eivinhj/cSLIM_nRF9160-DK_shield/readme.md

Shield design files of cSLIM shield hardware for nRF9160-DK.

Edit using KiCad: https://www.kicad.org/
