eivinhj/cSLIM_nRF9160-DK_shield/cSLIM-SHIELD/cSLIM-shield_bom2.xlsx

Id | Designator | Package | Quantity | Designation | Supplier and ref | OK?
1 | R801,R603,R701,R702,R703,R901,R902,R903,R906,R802,R803,R203,R804,R805,R1102,R1103 | R_0805_2012Metric | 16 | 100k | M
2 | P101 | Socket_Strip_Arduino_1x08 | 1 | Power | M
3 | P102 | Socket_Strip_Arduino_1x06 | 1 | Analog | M
4 | P104 | Socket_Strip_Arduino_1x10 | 1 | Digital | M
5 | P105,P106 | Socket_Strip_Arduino_1x08 | 2 | Digital | M
6 | H101,H102,H103,H106,H104,H105 | Arduino_1pin | 6 | CONN_01X01 | DNP
7 | P103 | PinHeader_2x03_P2.54mm_Vertical | 1 | Conn_02x03_Odd_Even | M
8 | C301,C401,C402,C403,C404,C405,C601,C604,C606,C901,C1001,C806,C810 | C_0603_1608Metric | 13 | 100nF | M
9 | C501 | C_0603_1608Metric | 1 | 12pF | M
10 | C602,C603,C902 | C_0603_1608Metric | 3 | 1uF | M
11 | C605 | C_0603_1608Metric | 1 | 10uF | M
12 | C607 | C_0603_1608Metric | 1 | 22uF | M
13 | FB501 | C_0603_1608Metric | 1 | 500mA | M
14 | IC201 | WLR089U0IRM | 1 | WLR089U0-I_RM | M
15 | IC301 | SOIC127P600X175-8N | 1 | MAX3486ESA+ | M
16 | IC302 | SOP65P490X110-8N | 1 | MAX3471EUA+ | DNP
17 | IC401 | SOP65P640X110-16N | 1 | MAX3221CUE+ | M
18 | IC601 | SOP65P640X120-8N | 1 | TPS2113PWR | M
19 | IC701,IC902,IC801 | SOP65P640X120-16N | 3 | SN74AVC4T774PWR | M
20 | IC702,IC903,IC802,IC202 | SOT95P230X110-3N | 4 | NX2301P,215 | M
21 | IC901 | NEO-M8T | 1 | NEO-M9N-00B | Best.tdl
22 | J101,J102 | PinSocket_1x03_P2.54mm_Vertical | 2 | Conn_01x03_Male
23 | J501,J505,J511 | PinSocket_1x02_P2.54mm_Vertical | 3 | Conn_01x02_Male | M
24 | J502 | PinSocket_1x04_P2.54mm_Vertical | 1 | Conn_01x04 | M
25 | J503 | PinSocket_1x06_P2.54mm_Vertical | 1 | Conn_01x06 | M
26 | J506 | 1040310811 | 1 | 104031-0811 | M
27 | J507 | CONUFL001-SMD | 1 | CONUFL001-SMD-T | https://www.digikey.no/product-detail/en/linx-technologies-inc/CONUFL001-SMD-T/CONUFL001-SMD-TCT-ND/7427733
28 | J508 | SHF-105-01-X-D-SM | 1 | SHF-105-01-L-D-SM | 1
29 | J509,J510 | BM05BZESSTBTLFSN | 2 | BM05B-ZESS-TBT__LF__SN_ | https://no.farnell.com/jst-japan-solderless-terminals/bm05b-zess-tbt/header-ze-top-smt-1-5mm-5way/dp/2320430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
30 | L601 | LPS3015 | 1 | LPS3015-222MRB | M
31 | L901 | L_0805_2012Metric | 1 | L | DNP
32 | LED501 | LEDC2012X75N | 1 | APT2012LSECK_J3-PRV | M
33 | LED502 | LEDC2012X85N | 1 | APT2012LSYCK_J3-PRV | M
34 | LED503 | LEDC2012X85N | 1 | APT2012LZGCK | M
35 | LED504,LED505 | LEDC2012X85N | 2 | APT2012LVBC_D | M
36 | Q901 | SOTFL50P160X60-6N | 1 | SI1040X-T1-GE3 | DNP
37 | R301 | R_0805_2012Metric | 1 | 120R | M
38 | R501,R502 | R_0805_2012Metric | 2 | 15R | M
39 | R503,R508,R509,R904,R511 | R_0805_2012Metric | 5 | 0R | M
40 | R504,R505 | R_0805_2012Metric | 2 | 820R | M
41 | R506,R507,R510 | R_0805_2012Metric | 3 | 330R | M
42 | R601,R609 | R_0805_2012Metric | 2 | 240k | M
43 | R602,R606 | R_0805_2012Metric | 2 | 1M | M
44 | R604 | R_0805_2012Metric | 1 | 390R | M
45 | R605 | R_0805_2012Metric | 1 | 1k | M
46 | R607 | R_0805_2012Metric | 1 | 100R | M
47 | R608 | R_0805_2012Metric | 1 | 1M2 | M
48 | R905 | R_0805_2012Metric | 1 | 10R | M
49 | R1001,R1002 | R_0805_2012Metric | 2 | 33R | M
50 | R1003 | R_0805_2012Metric | 1 | 50R | M
51 | S201 | SOIC127P671X170-16N | 1 | 97C08ST | M
52 | S601,PB1,PB2 | TLSA070JLFS | 3 | TLS_A_070J_LFS | M
53 | U501 | SOT-23-6 | 1 | USBLC6-2SC6 | M
54 | U601 | Texas_DRC0010J_ThermalVias | 1 | TPS63000 | M
55 | C608 | C_0603_1608Metric | 1 | 1.8pF | M
56 | C807 | C_0603_1608Metric | 1 | 1uF/50V | M
57 | FB801,FB802 | C_0603_1608Metric | 2 | Ferrite_Bead | M
58 | J504 | 10119313302TLF | 1 | 10119313-302TLF | M
59 | J802 | 52746-1071 | 1 | 52746-1071 | M
60 | R101,R102 | R_0805_2012Metric | 2 | 4.7k | M
61 | R1101 | R_0805_2012Metric | 1 | 10k | M
62 | Y1101 | RV3032C7TAQA | 1 | RV-3032-C7-TA-QC
63 | IC1001 | SON65P323X328X55-8N | 1 | CY15B108QN-20LPXC | M
Extra
 |  | Wires for RS485 RS232 | 25 |  | https://no.rs-online.com/web/p/pre-crimped-leads/8201396/
 |  | Housing for connectors | 10 |  | https://no.rs-online.com/web/p/wire-housings-plugs/8201365/?matchtype=&pla-339234368854&gclsrc=aw.ds
 |  | GPS-antenna
 |  | LoRa-antenna
 |  | RS485-Wet cable connector
 |  | u.fl to screw terminal
 |  | vanntett boks
 |  | Batteri
 |  | Antennekabel
