eivinhj/cSLIM_nRF9160-DK_shield/(list of files, drawings)

Other design files:
cSLIM-SHIELD/cSLIM-shield_test_routing.dsn
cSLIM-SHIELD/cSLIM-shield_test_routing_net_classes.dsn
cSLIM-SHIELD/cSLIM-shield_test_routing_net_classes_2.dsn
cSLIM-SHIELD/cSLIM-shield_test_routing_net_classes_3.dsn
cSLIM-SHIELD/cSLIM-shield_test_routing_net_classes_4.dsn
cSLIM-SHIELD/cSLIM-shield_test_routing_net_classes_5.dsn
cSLIM-SHIELD/cSLIM-shield_test_routing_net_classes_6.dsn
cSLIM-SHIELD/cSLIM-shield_test_routing_net_classes_7.dsn
cSLIM-SHIELD/cSLIM-shield_test_routing_net_classes_10.dsn
