eivinhj/cSLIM_nRF9160-DK_shield/cSLIM-SHIELD/cSLIM-shield.kicad_pcb

## KiCad design cSLIM-SHIELD/cSLIM-shield.kicad_pcb (2021-08-10)

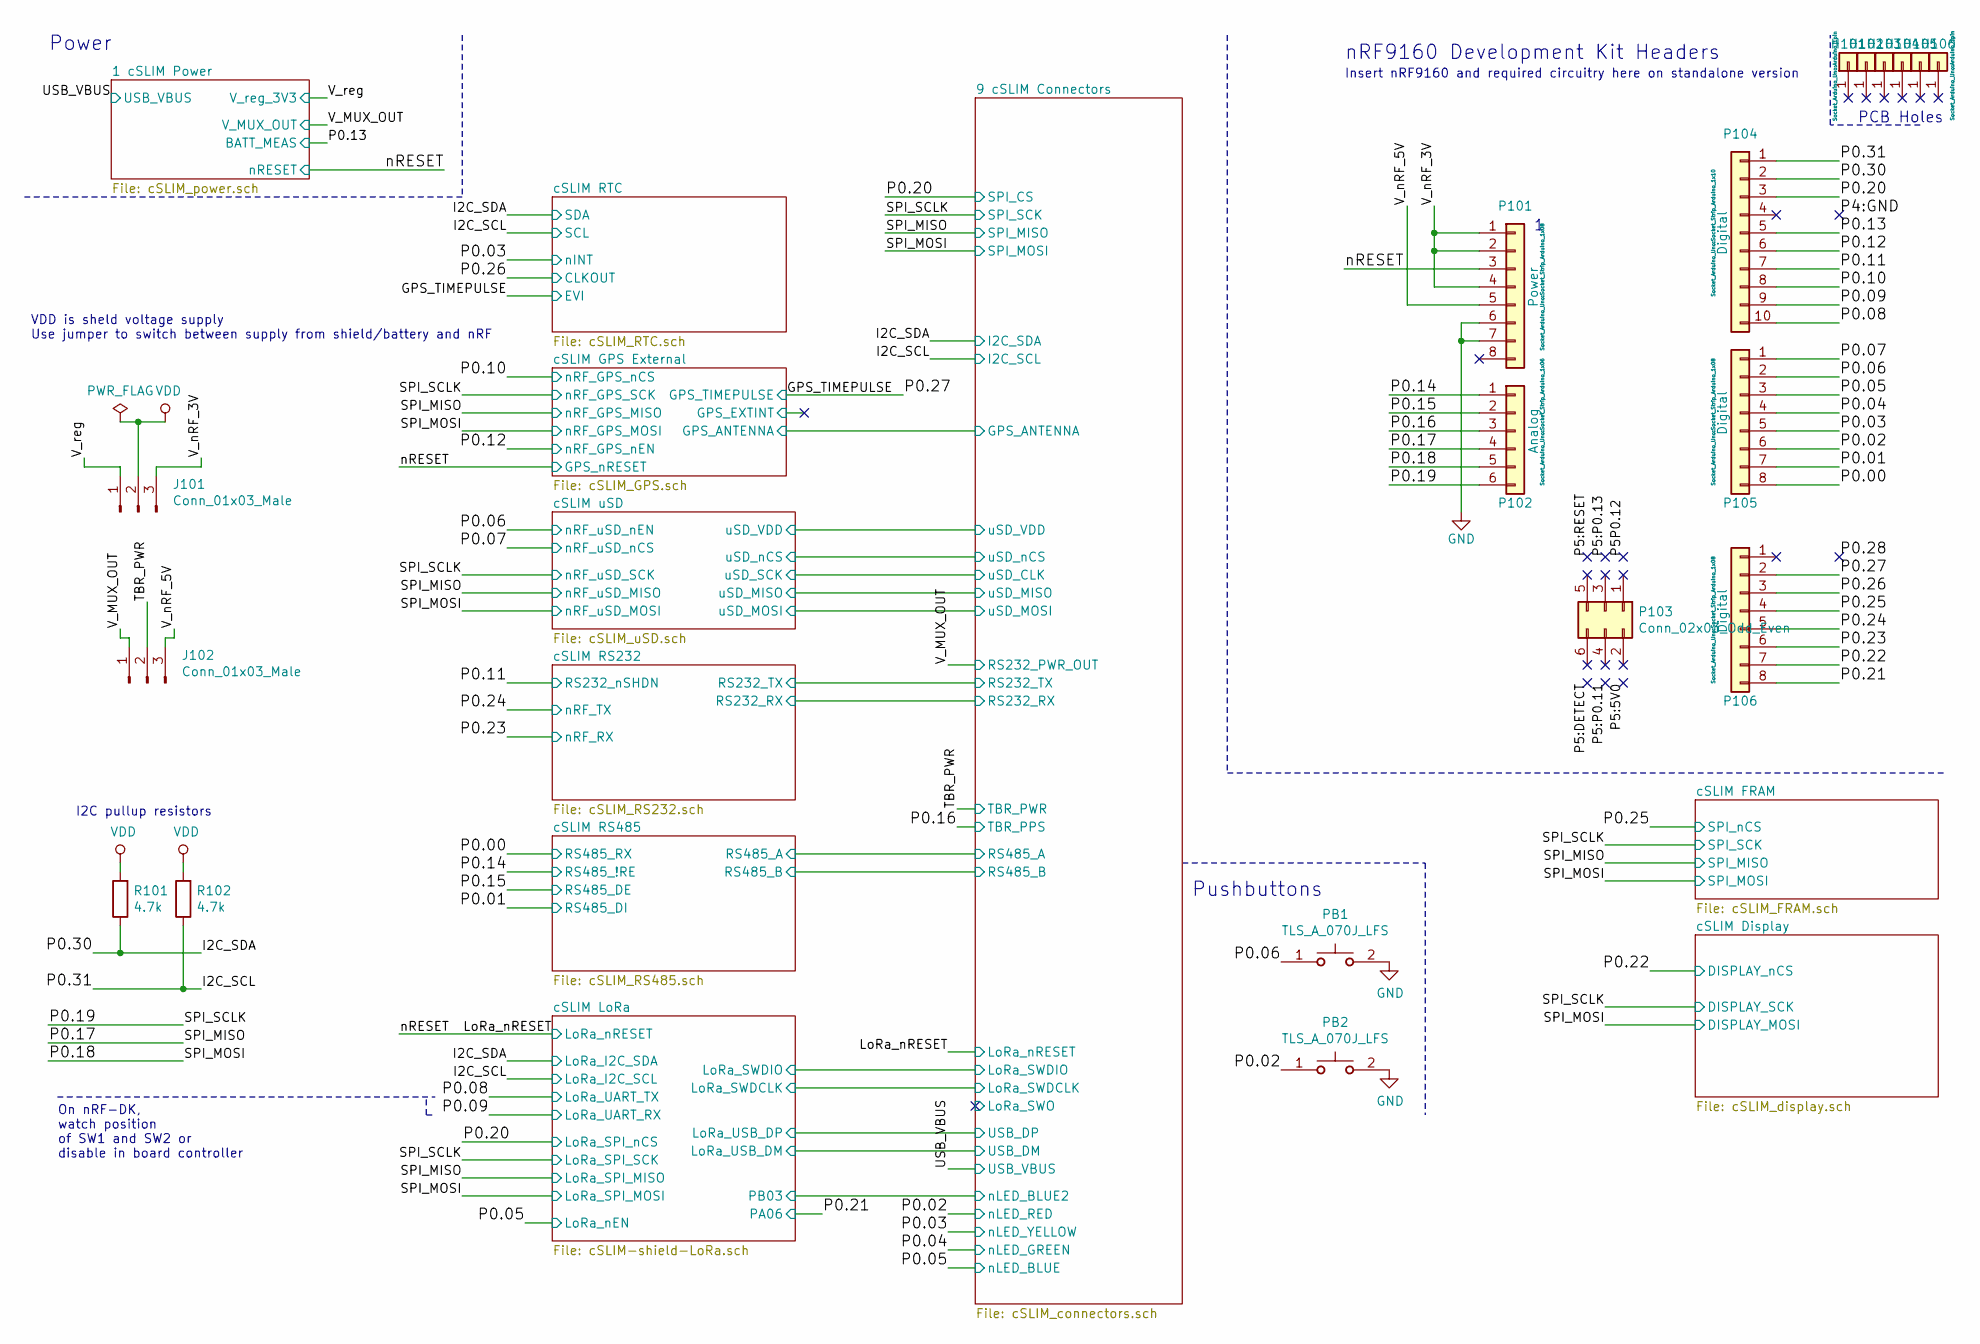
[picture p1: schematic cSLIM-shield.sch, cSLIM Overview]

Parts:
H101, H102, H103, H104, H105, H106: CONN_01X01; Arduino_1pin
J101, J102: Conn_01x03_Male; PinSocket_1x03_P2.54mm_Vertical
P101: Power; Socket_Strip_Arduino_1x08
P102: Analog; Socket_Strip_Arduino_1x06
P103: Conn_02x03_Odd_Even; PinHeader_2x03_P2.54mm_Vertical
P104: Digital; Socket_Strip_Arduino_1x10
P105, P106: Digital; Socket_Strip_Arduino_1x08
PB1, PB2: TLS_A_070J_LFS; TLSA070JLFS; Mouser Part Number 611-TLSA070JLFS
R101, R102: 4.7k; R_0805_2012Metric

Connections:
/GPS_TIMEPULSE: P106.2; also elsewhere on the board
/I2C_SCL: P104.1, R102.1; also elsewhere on the board
/I2C_SDA: P104.2, R101.1; also elsewhere on the board
/LoRa_nRESET: P101.3; also elsewhere on the board
/P0.00: P105.8; also elsewhere on the board
/P0.01: P105.7; also elsewhere on the board
/P0.02: P105.6, PB2.1; also elsewhere on the board
/P0.03: P105.5; also elsewhere on the board
/P0.04: P105.4; also elsewhere on the board
/P0.05: P105.3; also elsewhere on the board
/P0.06: P105.2, PB1.1; also elsewhere on the board
/P0.07: P105.1; also elsewhere on the board
/P0.08: P104.10; also elsewhere on the board
/P0.09: P104.9; also elsewhere on the board
/P0.10: P104.8; also elsewhere on the board
/P0.11: P104.7; also elsewhere on the board
/P0.12: P104.6; also elsewhere on the board
/P0.13: P104.5; also elsewhere on the board
/P0.14: P102.1; also elsewhere on the board
/P0.15: P102.2; also elsewhere on the board
/P0.16: P102.3; also elsewhere on the board
/P0.17: P102.4; also elsewhere on the board
/P0.18: P102.5; also elsewhere on the board
/P0.19: P102.6; also elsewhere on the board
/P0.20: P104.3; also elsewhere on the board
/P0.21: P106.8; also elsewhere on the board
/P0.22: P106.7; also elsewhere on the board
/P0.23: P106.6; also elsewhere on the board
/P0.24: P106.5; also elsewhere on the board
/P0.25: P106.4; also elsewhere on the board
/P0.26: P106.3; also elsewhere on the board
/TBR_PWR: J102.2; also elsewhere on the board
/V_MUX_OUT: J102.1; also elsewhere on the board
/V_nRF_3V: J101.3, P101.1, P101.2, P101.4
/V_nRF_5V: J102.3, P101.5
/V_reg: J101.1; also elsewhere on the board
GND: P101.6, P101.7, PB1.2, PB2.2; also elsewhere on the board
VDD: J101.2, R101.2, R102.2; also elsewhere on the board

Notes on the sheet:
PCB Holes
VDD is sheld voltage supply Use jumper to switch between supply from shield/battery and nRF
On nRF-DK, watch position of SW1 and SW2 or disable in board controller
nRF9160 Development Kit Headers
I2C pullup resistors
Pushbuttons
Insert nRF9160 and required circuitry here on standalone version
Power

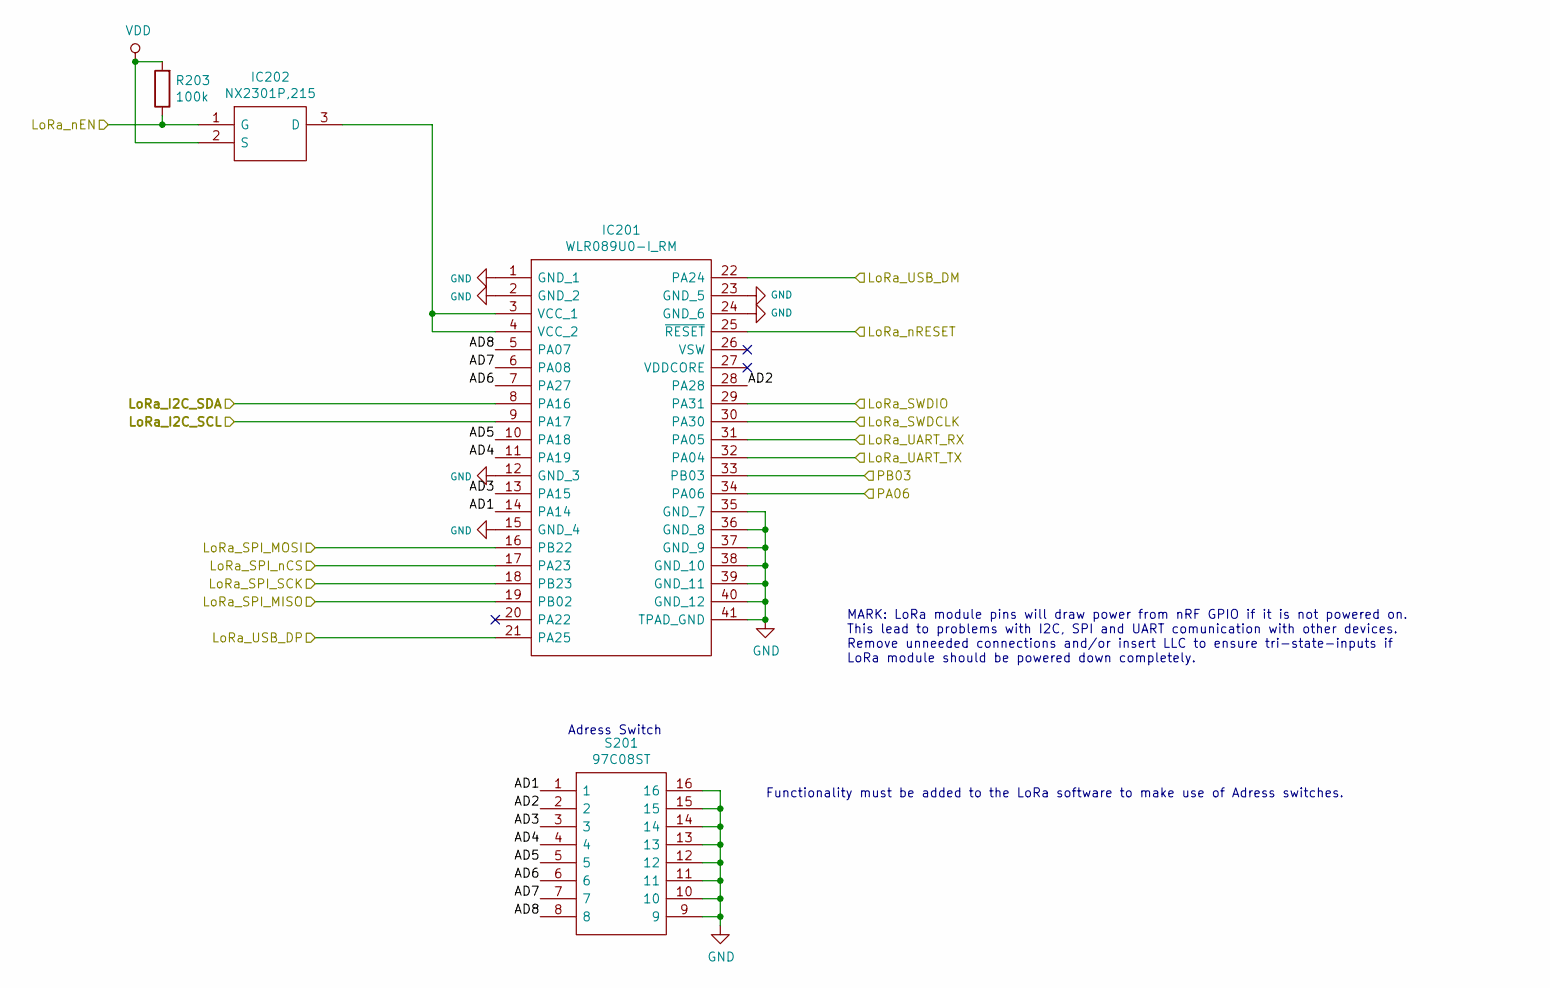
[picture p2: schematic cSLIM-shield-LoRa.sch, cSLIM LoRa Module]

Parts:
IC201: WLR089U0-I_RM; WLR089U0IRM; Mouser Part Number 579-WLR089U0-I/RM
IC202: NX2301P,215; SOT95P230X110-3N; Mouser Part Number 771-NX2301P215
R203: 100k; R_0805_2012Metric
S201: 97C08ST; SOIC127P671X170-16N; Mouser Part Number 706-97C08ST

Connections:
/9 cSLIM Connectors/LoRa_SWDCLK: IC201.30 (PA30); also elsewhere on the board
/9 cSLIM Connectors/LoRa_SWDIO: IC201.29 (PA31); also elsewhere on the board
/I2C_SCL: IC201.9 (PA17); also elsewhere on the board
/I2C_SDA: IC201.8 (PA16); also elsewhere on the board
/LoRa_nRESET: IC201.25 (~RESET); also elsewhere on the board
/P0.05: IC202.1 (G), R203.1; also elsewhere on the board
/P0.08: IC201.32 (PA04); also elsewhere on the board
/P0.09: IC201.31 (PA05); also elsewhere on the board
/P0.17: IC201.19 (PB02); also elsewhere on the board
/P0.18: IC201.16 (PB22); also elsewhere on the board
/P0.19: IC201.18 (PB23); also elsewhere on the board
/P0.20: IC201.17 (PA23); also elsewhere on the board
/P0.21: IC201.34 (PA06); also elsewhere on the board
/cSLIM LoRa/AD1: IC201.14 (PA14), S201.1
/cSLIM LoRa/AD2: IC201.28 (PA28), S201.2
/cSLIM LoRa/AD3: IC201.13 (PA15), S201.3
/cSLIM LoRa/AD4: IC201.11 (PA19), S201.4
/cSLIM LoRa/AD5: IC201.10 (PA18), S201.5
/cSLIM LoRa/AD6: IC201.7 (PA27), S201.6
/cSLIM LoRa/AD7: IC201.6 (PA08), S201.7
/cSLIM LoRa/AD8: IC201.5 (PA07), S201.8
/cSLIM LoRa/LoRa_USB_DM: IC201.22 (PA24); also elsewhere on the board
/cSLIM LoRa/LoRa_USB_DP: IC201.21 (PA25); also elsewhere on the board
/cSLIM LoRa/PB03: IC201.33 (PB03); also elsewhere on the board
GND: IC201.1 (GND_1), IC201.2 (GND_2), IC201.12 (GND_3), IC201.15 (GND_4), IC201.23 (GND_5), IC201.24 (GND_6), IC201.35 (GND_7), IC201.36 (GND_8), IC201.37 (GND_9), IC201.38 (GND_10), IC201.39 (GND_11), IC201.40 (GND_12), IC201.41 (TPAD_GND), S201.9, S201.10, S201.11, S201.12, S201.13, S201.14, S201.15, S201.16; also elsewhere on the board
unnamed: IC201.3 (VCC_1), IC201.4 (VCC_2), IC202.3 (D)
VDD: IC202.2 (S), R203.2; also elsewhere on the board

Notes on the sheet:
Adress Switch
MARK: LoRa module pins will draw power from nRF GPIO if it is not powered on. This lead to problems with I2C, SPI and UART comunication with other devices. Remove unneeded connections and/or insert LLC to ensure tri-state-inputs if LoRa module should be powered down completely.
Functionality must be added to the LoRa software to make use of Adress switches.

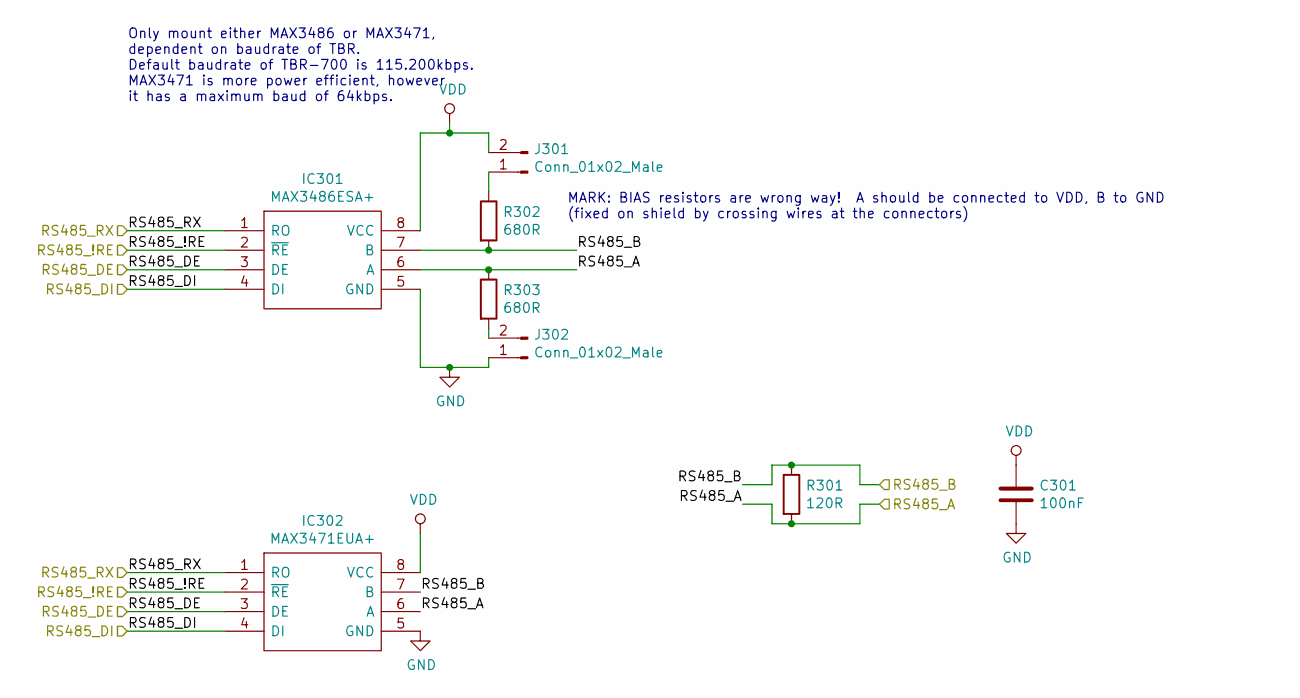
[picture p3: schematic cSLIM_RS485.sch, cSLIM RS485]

Parts:
C301: 100nF; C_0603_1608Metric
IC301: MAX3486ESA+; SOIC127P600X175-8N; Mouser Part Number 700-MAX3486ESA
IC302: MAX3471EUA+; SOP65P490X110-8N; Mouser Part Number 700-MAX3471EUA
J301, J302: Conn_01x02_Male; PinSocket_1x02_P2.54mm_Vertical
R301: 120R; R_0805_2012Metric
R302, R303: 680R; R_0805_2012Metric

Connections:
/9 cSLIM Connectors/RS485_A: IC301.6 (A), IC302.6 (A), R301.2, R303.1; also elsewhere on the board
/9 cSLIM Connectors/RS485_B: IC301.7 (B), IC302.7 (B), R301.1, R302.2; also elsewhere on the board
/P0.00: IC301.1 (RO), IC302.1 (RO); also elsewhere on the board
/P0.01: IC301.4 (DI), IC302.4 (DI); also elsewhere on the board
/P0.14: IC301.2 (~RE), IC302.2 (~RE); also elsewhere on the board
/P0.15: IC301.3 (DE), IC302.3 (DE); also elsewhere on the board
GND: C301.2, IC301.5 (GND), IC302.5 (GND), J302.1; also elsewhere on the board
unnamed: J301.1, R302.1
unnamed: J302.2, R303.2
VDD: C301.1, IC301.8 (VCC), IC302.8 (VCC), J301.2; also elsewhere on the board

Notes on the sheet:
Only mount either MAX3486 or MAX3471, dependent on baudrate of TBR. Default baudrate of TBR-700 is 115.200kbps. MAX3471 is more power efficient, however it has a maximum baud of 64kbps.
MARK: BIAS resistors are wrong way! A should be connected to VDD, B to GND (fixed on shield by crossing wires at the connectors)

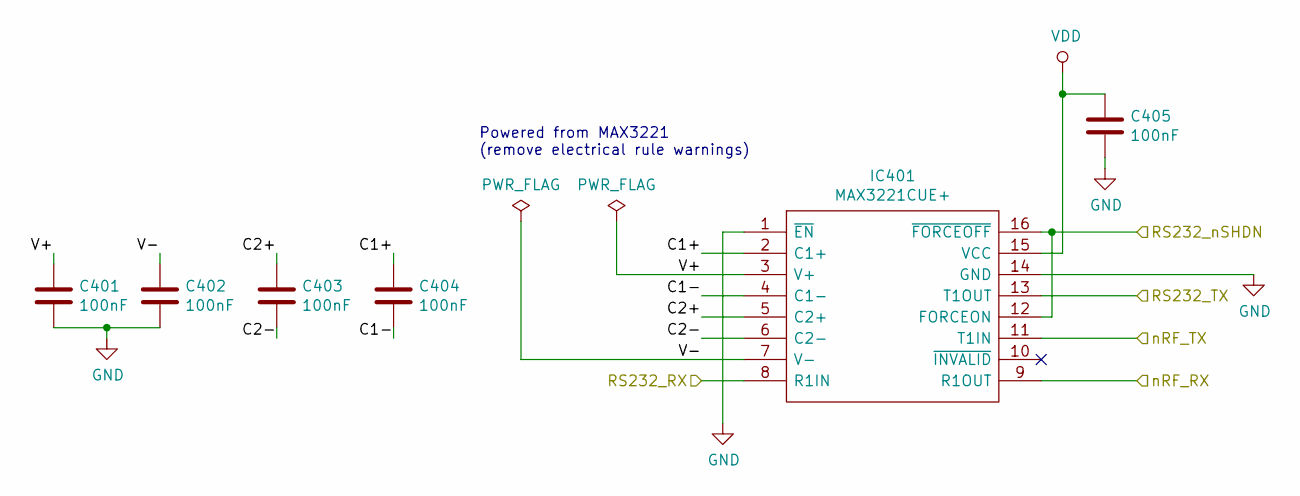
[picture p4: schematic cSLIM_RS232.sch, cSLIM RS232]

Parts:
C401, C402, C403, C404, C405: 100nF; C_0603_1608Metric
IC401: MAX3221CUE+; SOP65P640X110-16N; Mouser Part Number 700-MAX3221CUE

Connections:
/9 cSLIM Connectors/RS232_RX: IC401.8 (R1IN); also elsewhere on the board
/9 cSLIM Connectors/RS232_TX: IC401.13 (T1OUT); also elsewhere on the board
/P0.11: IC401.12 (FORCEON), IC401.16 (~FORCEOFF); also elsewhere on the board
/P0.23: IC401.9 (R1OUT); also elsewhere on the board
/P0.24: IC401.11 (T1IN); also elsewhere on the board
/cSLIM RS232/C1+: C404.1, IC401.2 (C1+)
/cSLIM RS232/C1-: C404.2, IC401.4 (C1-)
/cSLIM RS232/C2+: C403.1, IC401.5 (C2+)
/cSLIM RS232/C2-: C403.2, IC401.6 (C2-)
/cSLIM RS232/V+: C401.1, IC401.3 (V+)
/cSLIM RS232/V-: C402.1, IC401.7 (V-)
GND: C401.2, C402.2, C405.2, IC401.1 (~EN), IC401.14 (GND); also elsewhere on the board
VDD: C405.1, IC401.15 (VCC); also elsewhere on the board

Notes on the sheet:
Powered from MAX3221 (remove electrical rule warnings)

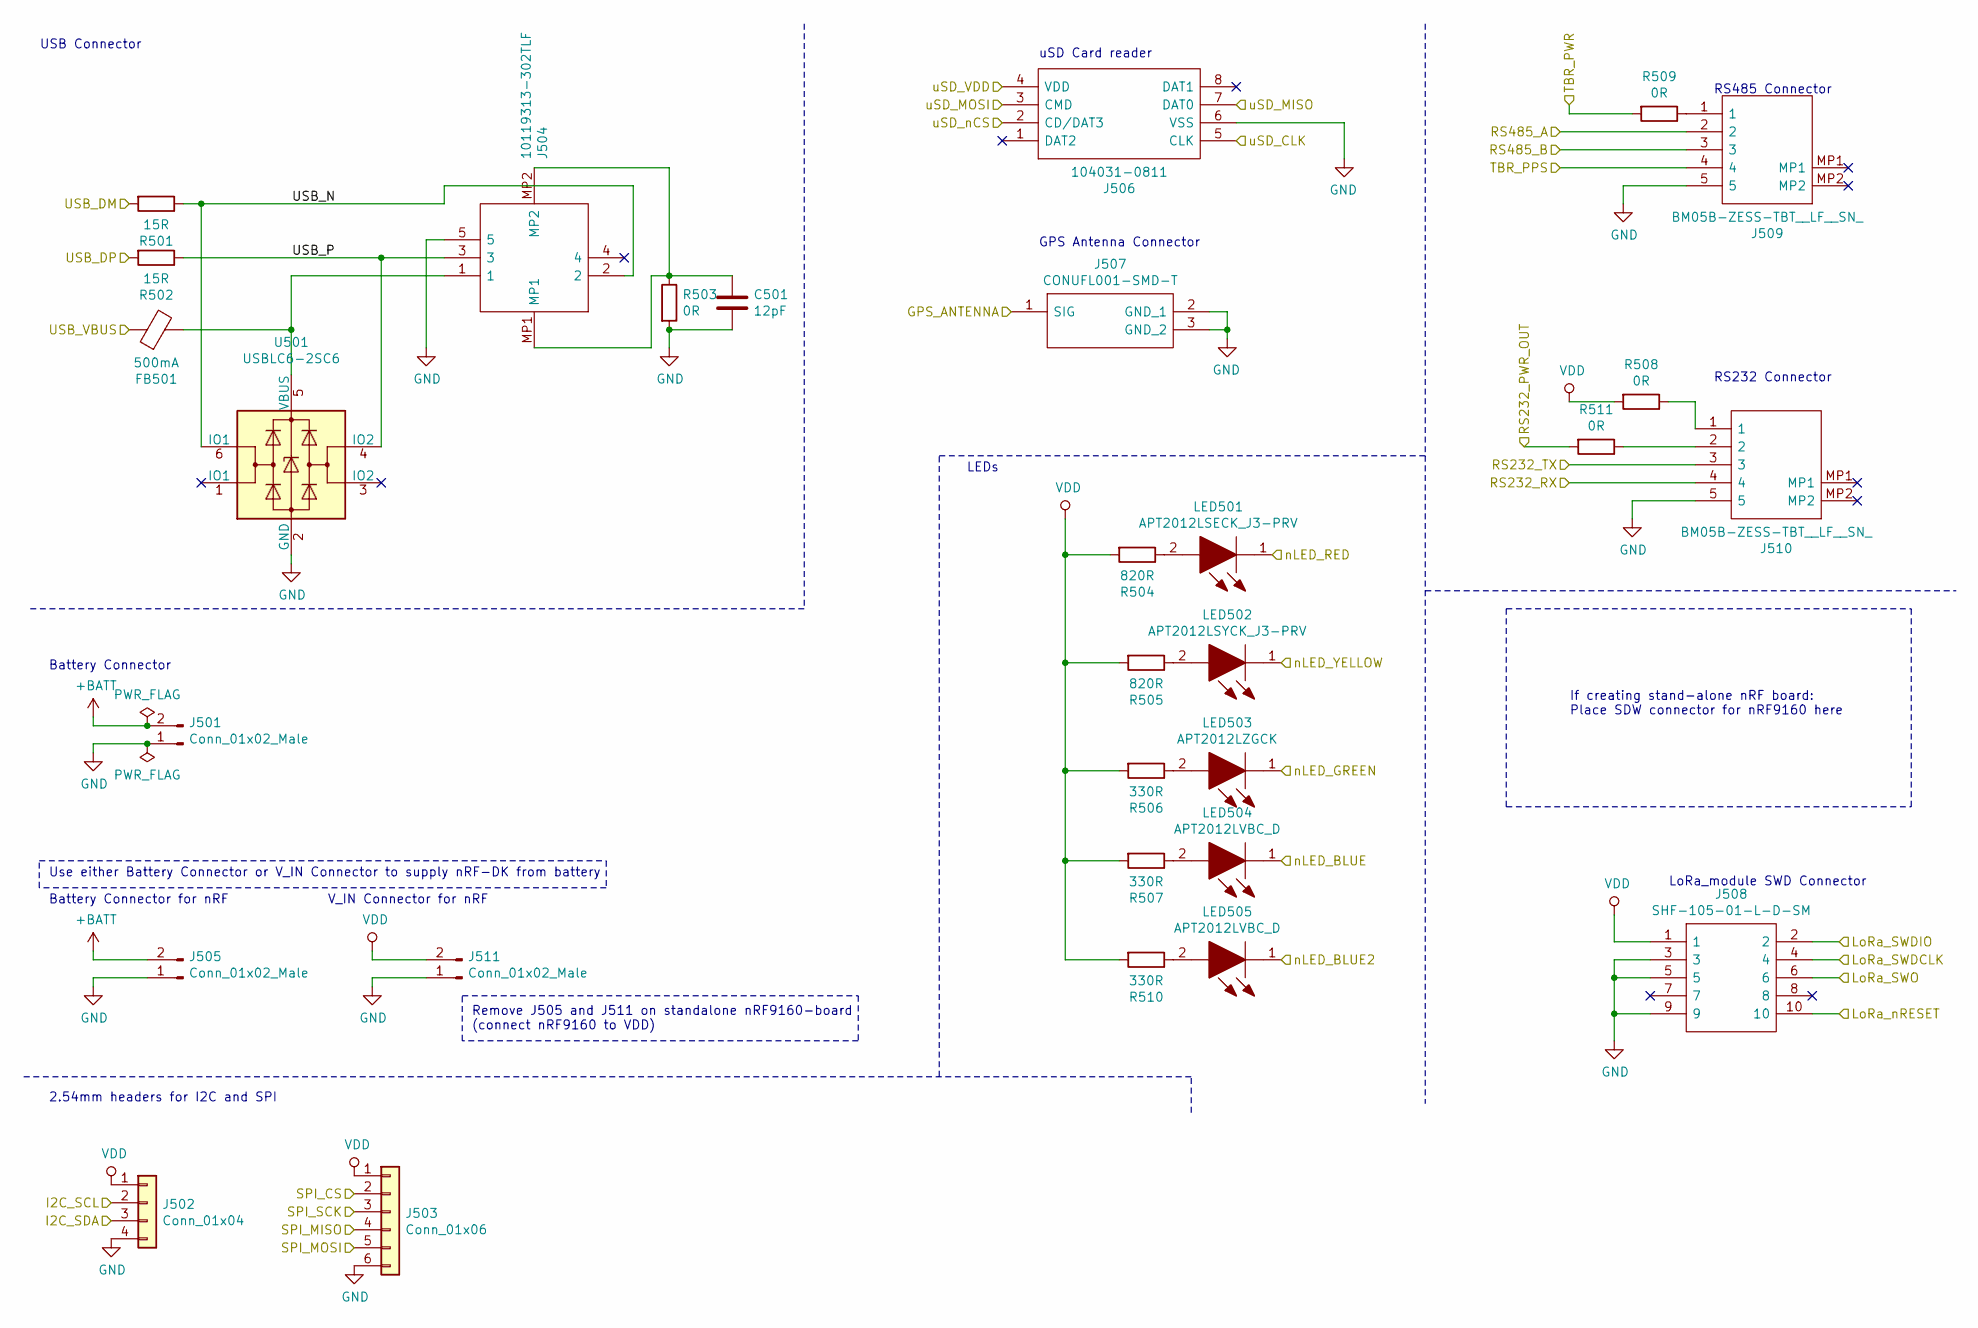
[picture p5: schematic cSLIM_connectors.sch, cSLIM Connectors]

Parts:
C501: 12pF; C_0603_1608Metric
FB501: 500mA; C_0603_1608Metric
J501, J505, J511: Conn_01x02_Male; PinSocket_1x02_P2.54mm_Vertical
J502: Conn_01x04; PinSocket_1x04_P2.54mm_Vertical
J503: Conn_01x06; PinSocket_1x06_P2.54mm_Vertical
J504: 10119313-302TLF; 10119313302TLF; Mouser Part Number 649-10119313-302TLF
J506: 104031-0811; 1040310811; Mouser Part Number 538-104031-0811
J507: CONUFL001-SMD-T; CONUFL001-SMD; Mouser Part Number 712-CONUFL001-SMD-T
J508: SHF-105-01-L-D-SM; SHF-105-01-X-D-SM; Mouser Part Number 200-SHF10501LDSM
J509, J510: BM05B-ZESS-TBT__LF__SN_; BM05BZESSTBTLFSN; Manufacturer_Part_Number BM05B-ZESS-TBT (LF)(SN)
LED501: APT2012LSECK_J3-PRV; LEDC2012X75N; Mouser Part Number 604-APT2012LSECKJ3RV
LED502: APT2012LSYCK_J3-PRV; LEDC2012X85N; Mouser Part Number 604-APT2012LSYCKJ3RV
LED503: APT2012LZGCK; LEDC2012X85N; Mouser Part Number 604-APT2012LZGCK
LED504, LED505: APT2012LVBC_D; LEDC2012X85N; Mouser Part Number 604-APT2012LVBCD
R501, R502: 15R; R_0805_2012Metric
R503, R508, R509, R511: 0R; R_0805_2012Metric
R504, R505: 820R; R_0805_2012Metric
R506, R507, R510: 330R; R_0805_2012Metric
U501: USBLC6-2SC6; SOT-23-6

Connections:
+BATT: J501.2, J505.2; also elsewhere on the board
/9 cSLIM Connectors/GPS_ANTENNA: J507.1 (SIG); also elsewhere on the board
/9 cSLIM Connectors/LoRa_SWDCLK: J508.4; also elsewhere on the board
/9 cSLIM Connectors/LoRa_SWDIO: J508.2; also elsewhere on the board
/9 cSLIM Connectors/LoRa_SWO: J508.6
/9 cSLIM Connectors/RS232_RX: J510.4; also elsewhere on the board
/9 cSLIM Connectors/RS232_TX: J510.3; also elsewhere on the board
/9 cSLIM Connectors/RS485_A: J509.2; also elsewhere on the board
/9 cSLIM Connectors/RS485_B: J509.3; also elsewhere on the board
/9 cSLIM Connectors/USB_N: J504.2, R501.1, U501.6 (IO1)
/9 cSLIM Connectors/USB_P: J504.3, R502.1, U501.4 (IO2)
/9 cSLIM Connectors/uSD_CLK: J506.5 (CLK); also elsewhere on the board
/9 cSLIM Connectors/uSD_MISO: J506.7 (DAT0); also elsewhere on the board
/9 cSLIM Connectors/uSD_MOSI: J506.3 (CMD); also elsewhere on the board
/9 cSLIM Connectors/uSD_VDD: J506.4 (VDD); also elsewhere on the board
/9 cSLIM Connectors/uSD_nCS: J506.2 (CD/DAT3); also elsewhere on the board
/I2C_SCL: J502.2; also elsewhere on the board
/I2C_SDA: J502.3; also elsewhere on the board
/LoRa_nRESET: J508.10; also elsewhere on the board
/P0.02: LED501.1; also elsewhere on the board
/P0.03: LED502.1; also elsewhere on the board
/P0.04: LED503.1; also elsewhere on the board
/P0.05: LED504.1; also elsewhere on the board
/P0.16: J509.4; also elsewhere on the board
/P0.17: J503.4; also elsewhere on the board
/P0.18: J503.5; also elsewhere on the board
/P0.19: J503.3; also elsewhere on the board
/P0.20: J503.2; also elsewhere on the board
/TBR_PWR: R509.2; also elsewhere on the board
/USB_VBUS: FB501.1; also elsewhere on the board
/V_MUX_OUT: R511.2; also elsewhere on the board
/cSLIM LoRa/LoRa_USB_DM: R501.2; also elsewhere on the board
/cSLIM LoRa/LoRa_USB_DP: R502.2; also elsewhere on the board
/cSLIM LoRa/PB03: LED505.1; also elsewhere on the board
GND: C501.2, J501.1, J502.4, J503.6, J504.5, J505.1, J506.6 (VSS), J507.2 (GND_1), J507.3 (GND_2), J508.3, J508.5, J508.9, J509.5, J510.5, J511.1, R503.2, U501.2 (GND); also elsewhere on the board
unnamed: C501.1, J504.MP1, J504.MP2, R503.1
unnamed: FB501.2, J504.1, U501.5 (VBUS)
unnamed: J509.1, R509.1
unnamed: J510.1, R508.1
unnamed: J510.2, R511.1
unnamed: LED501.2, R504.1
unnamed: LED502.2, R505.1
unnamed: LED503.2, R506.1
unnamed: LED504.2, R507.1
unnamed: LED505.2, R510.1
VDD: J502.1, J503.1, J508.1, J511.2, R504.2, R505.2, R506.2, R507.2, R508.2, R510.2; also elsewhere on the board

Notes on the sheet:
RS485 Connector
LoRa_module SWD Connector
uSD Card reader
USB Connector
Battery Connector
2.54mm headers for I2C and SPI
Battery Connector for nRF
V_IN Connector for nRF
Use either Battery Connector or V_IN Connector to supply nRF-DK from battery
RS232 Connector
GPS Antenna Connector
If creating stand-alone nRF board: Place SDW connector for nRF9160 here
Remove J505 and J511 on standalone nRF9160-board (connect nRF9160 to VDD)
LEDs

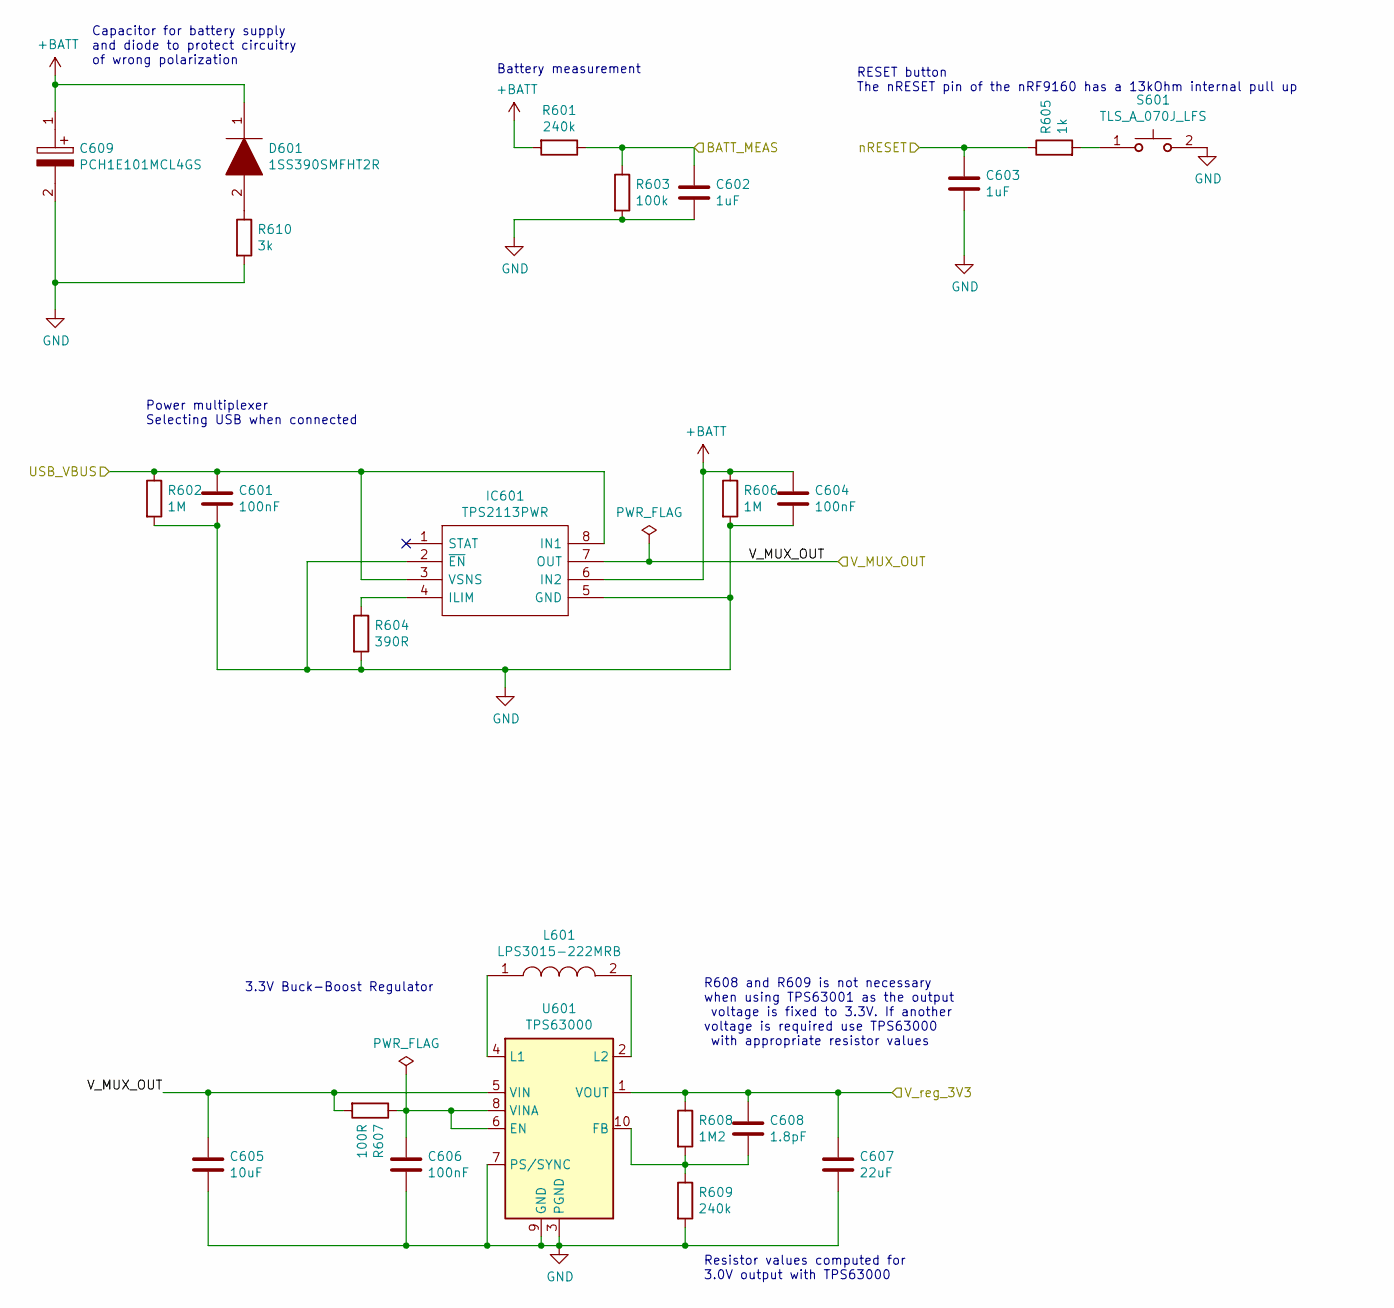
[picture p6: schematic cSLIM_power.sch, cSLIM Power]

Parts:
C601, C604, C606: 100nF; C_0603_1608Metric
C602, C603: 1uF; C_0603_1608Metric
C605: 10uF; C_0603_1608Metric
C607: 22uF; C_0603_1608Metric
C608: 1.8pF; C_0603_1608Metric
C609: PCH1E101MCL4GS; CAPAE660X840N; Mouser Part Number 647-PCH1E101MCL4GS
D601: 1SS390SMFHT2R; SODFL1608X70N; Mouser Part Number 755-1SS390SMFHT2R
IC601: TPS2113PWR; SOP65P640X120-8N; Mouser Part Number 595-TPS2113PWR
L601: LPS3015-222MRB; LPS3015; Mouser Part Number 994-LPS3015-103MRB
R601, R609: 240k; R_0805_2012Metric
R602, R606: 1M; R_0805_2012Metric
R603: 100k; R_0805_2012Metric
R604: 390R; R_0805_2012Metric
R605: 1k; R_0805_2012Metric
R607: 100R; R_0805_2012Metric
R608: 1M2; R_0805_2012Metric
R610: 3k; R_0805_2012Metric
S601: TLS_A_070J_LFS; TLSA070JLFS; Mouser Part Number 611-TLSA070JLFS
U601: TPS63000; Texas_DRC0010J_ThermalVias

Connections:
+BATT: C604.1, C609.1, D601.1, IC601.6 (IN2), R601.2, R606.1; also elsewhere on the board
/LoRa_nRESET: C603.1, R605.1; also elsewhere on the board
/P0.13: C602.1, R601.1, R603.1; also elsewhere on the board
/USB_VBUS: C601.1, IC601.3 (VSNS), IC601.8 (IN1), R602.1; also elsewhere on the board
/V_MUX_OUT: C605.1, IC601.7 (OUT), R607.2, U601.5 (VIN); also elsewhere on the board
/V_reg: C607.1, C608.1, R608.1, U601.1 (VOUT); also elsewhere on the board
GND: C601.2, C602.2, C603.2, C604.2, C605.2, C606.2, C607.2, C609.2, IC601.2 (~EN), IC601.5 (GND), R602.2, R603.2, R604.2, R606.2, R609.2, R610.2, S601.2, U601.3 (PGND), U601.7 (PS/SYNC), U601.9 (GND), U601.11 (PGND); also elsewhere on the board
unnamed: C606.1, R607.1, U601.6 (EN), U601.8 (VINA)
unnamed: C608.2, R608.2, R609.1, U601.10 (FB)
unnamed: D601.2, R610.1
unnamed: IC601.4 (ILIM), R604.1
unnamed: L601.1, U601.4 (L1)
unnamed: L601.2, U601.2 (L2)
unnamed: R605.2, S601.1

Notes on the sheet:
RESET button The nRESET pin of the nRF9160 has a 13kOhm internal pull up
Battery measurement
Power multiplexer Selecting USB when connected
3.3V Buck-Boost Regulator
R608 and R609 is not necessary when using TPS63001 as the output voltage is fixed to 3.3V. If another voltage is required use TPS63000 with appropriate resistor values
Resistor values computed for 3.0V output with TPS63000
Capacitor for battery supply and diode to protect circuitry of wrong polarization

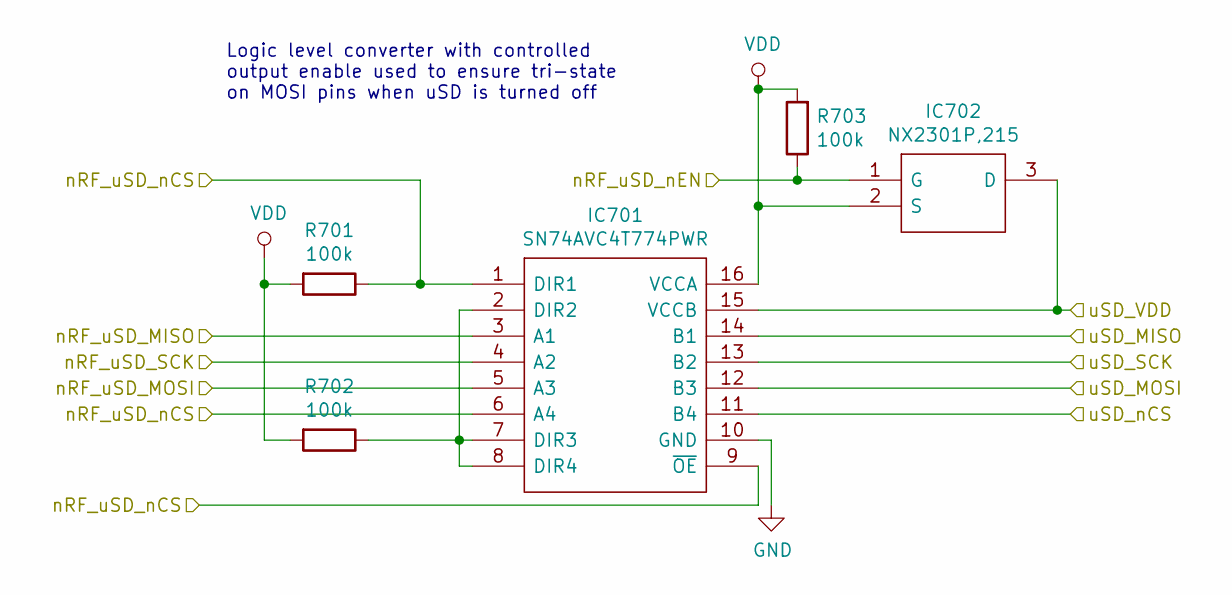
[picture p7: schematic cSLIM_uSD.sch, cSLIM uSD]

Parts:
IC701: SN74AVC4T774PWR; SOP65P640X120-16N; Mouser Part Number 595-SN74AVC4T774PWR
IC702: NX2301P,215; SOT95P230X110-3N; Mouser Part Number 771-NX2301P215
R701, R702, R703: 100k; R_0805_2012Metric

Connections:
/9 cSLIM Connectors/uSD_CLK: IC701.13 (B2); also elsewhere on the board
/9 cSLIM Connectors/uSD_MISO: IC701.14 (B1); also elsewhere on the board
/9 cSLIM Connectors/uSD_MOSI: IC701.12 (B3); also elsewhere on the board
/9 cSLIM Connectors/uSD_VDD: IC701.15 (VCCB), IC702.3 (D); also elsewhere on the board
/9 cSLIM Connectors/uSD_nCS: IC701.11 (B4); also elsewhere on the board
/P0.06: IC702.1 (G), R703.1; also elsewhere on the board
/P0.07: IC701.1 (DIR1), IC701.6 (A4), IC701.9 (~OE), R701.1; also elsewhere on the board
/P0.17: IC701.3 (A1); also elsewhere on the board
/P0.18: IC701.5 (A3); also elsewhere on the board
/P0.19: IC701.4 (A2); also elsewhere on the board
GND: IC701.10 (GND); also elsewhere on the board
unnamed: IC701.2 (DIR2), IC701.7 (DIR3), IC701.8 (DIR4), R702.1
VDD: IC701.16 (VCCA), IC702.2 (S), R701.2, R702.2, R703.2; also elsewhere on the board

Notes on the sheet:
Logic level converter with controlled output enable used to ensure tri-state on MOSI pins when uSD is turned off

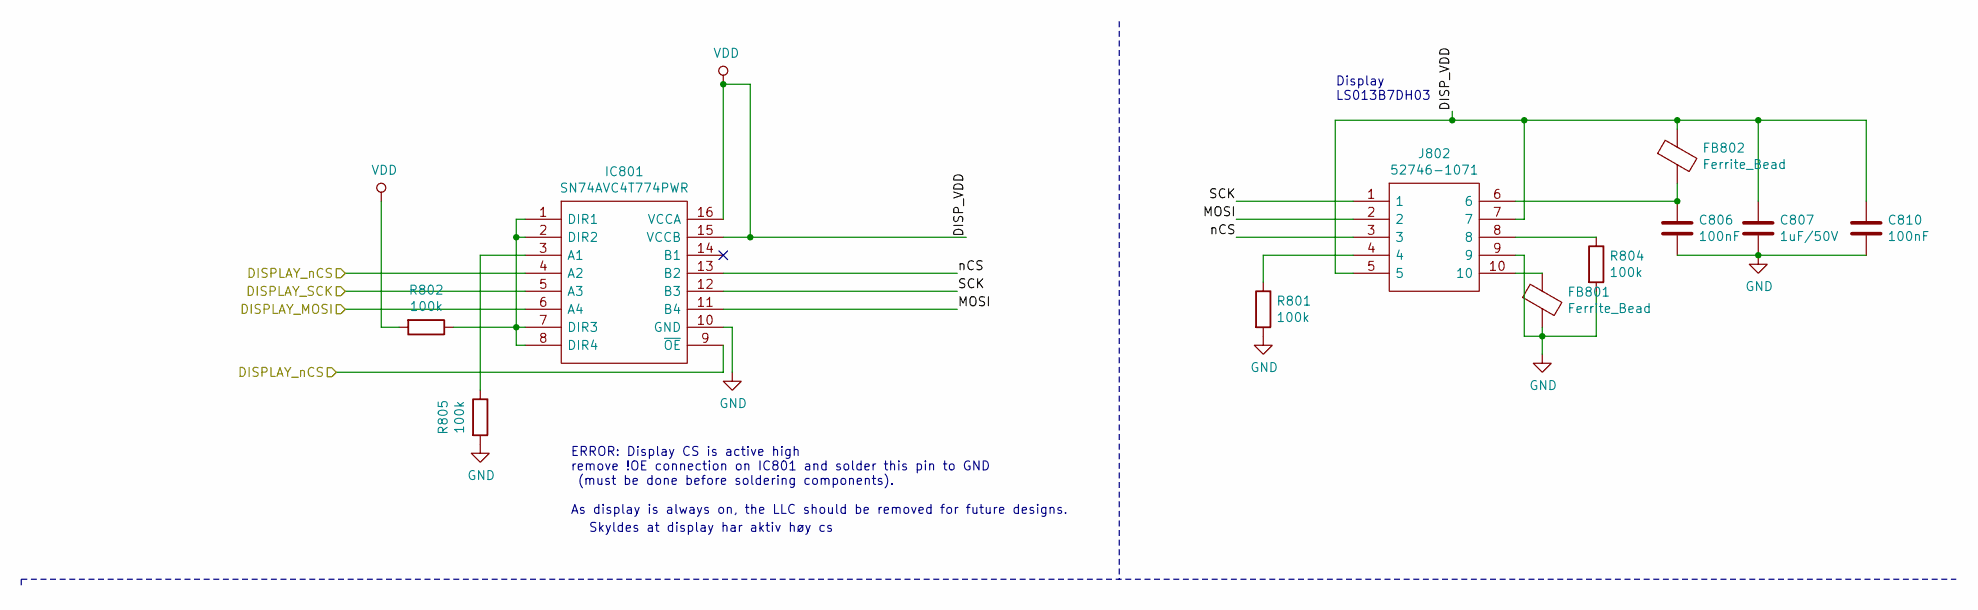
[picture p8: schematic cSLIM_display.sch, cSLIM Display]

Parts:
C806, C810: 100nF; C_0603_1608Metric
C807: 1uF/50V; C_0603_1608Metric
FB801, FB802: Ferrite_Bead; C_0603_1608Metric
IC801: SN74AVC4T774PWR; SOP65P640X120-16N; Mouser Part Number 595-SN74AVC4T774PWR
J802: 52746-1071; Mouser Part Number 538-52746-1071
R801, R802, R804, R805: 100k; R_0805_2012Metric

Connections:
/P0.18: IC801.6 (A4); also elsewhere on the board
/P0.19: IC801.5 (A3); also elsewhere on the board
/P0.22: IC801.4 (A2), IC801.9 (~OE); also elsewhere on the board
/cSLIM Display/MOSI: IC801.11 (B4), J802.2
/cSLIM Display/SCK: IC801.12 (B3), J802.1
/cSLIM Display/nCS: IC801.13 (B2), J802.3
GND: C806.2, C807.2, C810.2, FB801.2, IC801.10 (GND), J802.9, R801.2, R804.2, R805.2; also elsewhere on the board
unnamed: C806.1, FB802.2, J802.6
unnamed: FB801.1, J802.10
unnamed: IC801.1 (DIR1), IC801.2 (DIR2), IC801.7 (DIR3), IC801.8 (DIR4), R802.1
unnamed: IC801.3 (A1), R805.1
unnamed: J802.4, R801.1
unnamed: J802.8, R804.1
VDD: C807.1, C810.1, FB802.1, IC801.15 (VCCB), IC801.16 (VCCA), J802.5, J802.7, R802.2; also elsewhere on the board

Notes on the sheet:
Display LS013B7DH03
ERROR: Display CS is active high remove !OE connection on IC801 and solder this pin to GND (must be done before soldering components). As display is always on, the LLC should be removed for future designs.
Skyldes at display har aktiv høy cs
