eivinhj/cSLIM_nRF9160-DK_shield/cSLIM-SHIELD/cSLIM-shield.kicad_pcb

## KiCad design cSLIM-SHIELD/cSLIM-shield.kicad_pcb (continued)

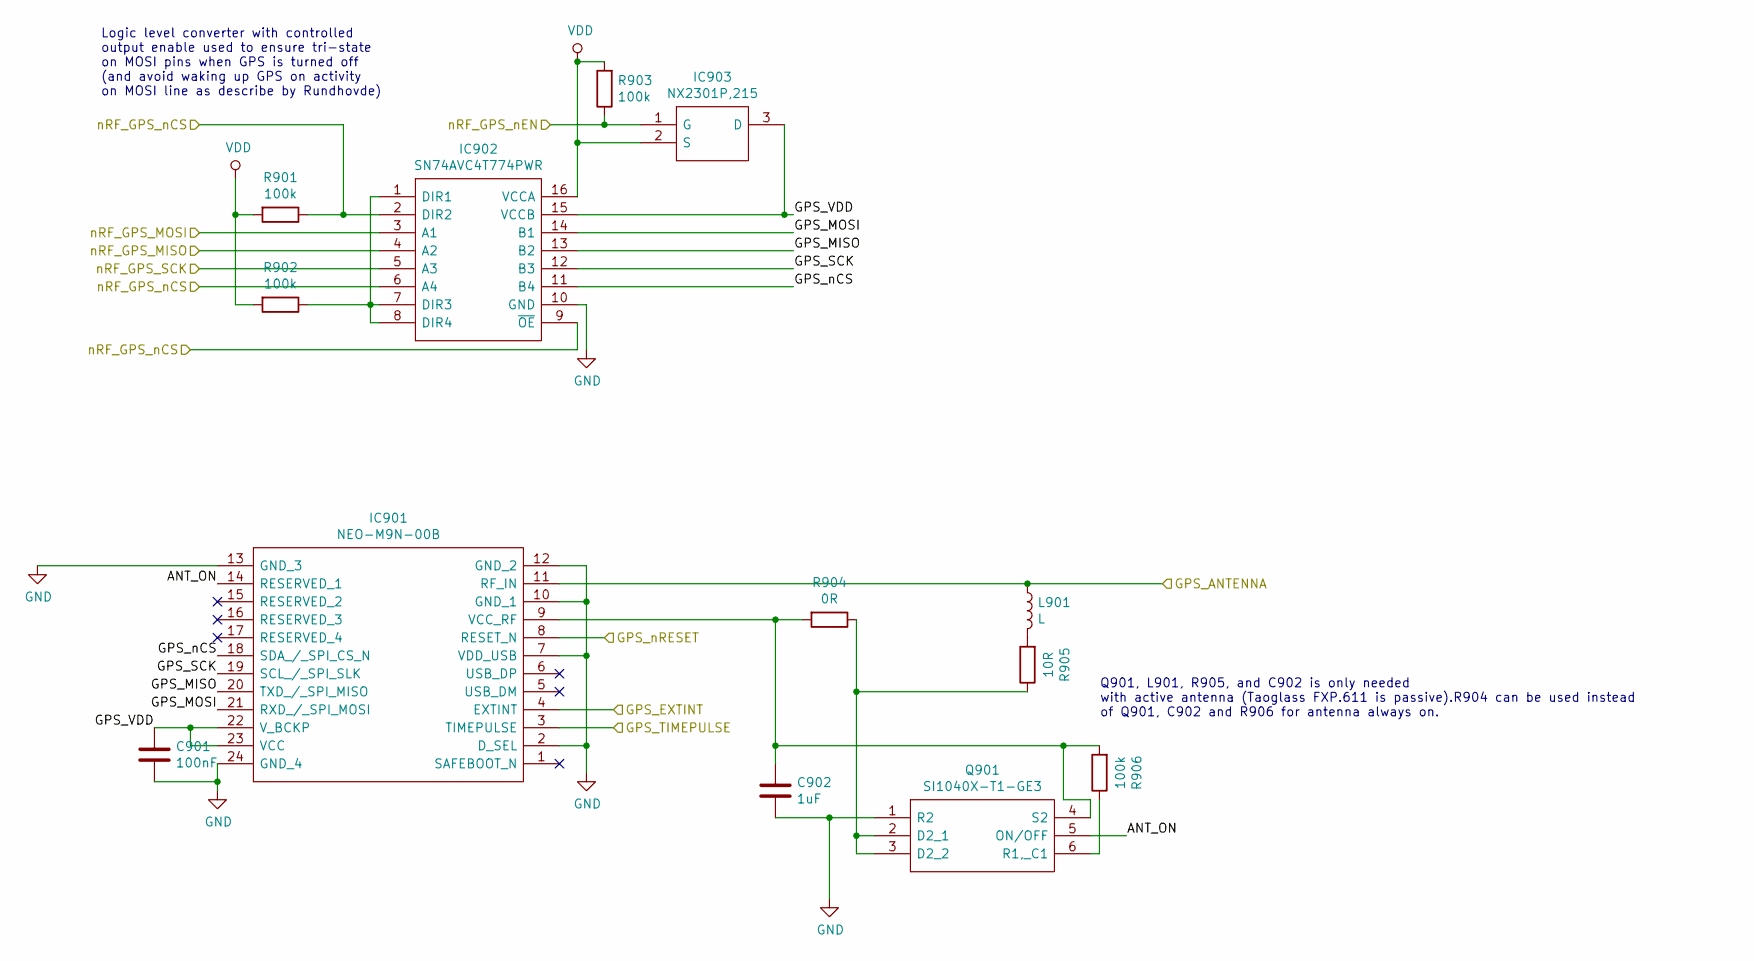
[picture p9: schematic cSLIM_GPS.sch, cSLIM External GPS]

Parts:
C901: 100nF; C_0603_1608Metric
C902: 1uF; C_0603_1608Metric
IC901: NEO-M9N-00B; NEO-M8T; Mouser Part Number 377-NEO-M8N-0
IC902: SN74AVC4T774PWR; SOP65P640X120-16N; Mouser Part Number 595-SN74AVC4T774PWR
IC903: NX2301P,215; SOT95P230X110-3N; Mouser Part Number 771-NX2301P215
L901: L; L_0805_2012Metric
Q901: SI1040X-T1-GE3; SOTFL50P160X60-6N; Mouser Part Number 781-SI1040X-T1-GE3
R901, R902, R903, R906: 100k; R_0805_2012Metric
R904: 0R; R_0805_2012Metric
R905: 10R; R_0805_2012Metric

Connections:
/9 cSLIM Connectors/GPS_ANTENNA: IC901.11 (RF_IN), L901.1; also elsewhere on the board
/GPS_TIMEPULSE: IC901.3 (TIMEPULSE); also elsewhere on the board
/LoRa_nRESET: IC901.8 (RESET_N); also elsewhere on the board
/P0.10: IC902.2 (DIR2), IC902.6 (A4), IC902.9 (~OE), R901.1; also elsewhere on the board
/P0.12: IC903.1 (G), R903.1; also elsewhere on the board
/P0.17: IC902.4 (A2); also elsewhere on the board
/P0.18: IC902.3 (A1); also elsewhere on the board
/P0.19: IC902.5 (A3); also elsewhere on the board
/cSLIM GPS External/ANT_ON: IC901.14 (RESERVED_1), Q901.5 (ON/OFF)
/cSLIM GPS External/GPS_EXTINT: IC901.4 (EXTINT)
/cSLIM GPS External/GPS_MISO: IC901.20 (TXD_/_SPI_MISO), IC902.13 (B2)
/cSLIM GPS External/GPS_MOSI: IC901.21 (RXD_/_SPI_MOSI), IC902.14 (B1)
/cSLIM GPS External/GPS_SCK: IC901.19 (SCL_/_SPI_SLK), IC902.12 (B3)
/cSLIM GPS External/GPS_VDD: C901.1, IC901.22 (V_BCKP), IC901.23 (VCC), IC902.15 (VCCB), IC903.3 (D)
/cSLIM GPS External/GPS_nCS: IC901.18 (SDA_/_SPI_CS_N), IC902.11 (B4)
GND: C901.2, C902.2, IC901.2 (D_SEL), IC901.7 (VDD_USB), IC901.10 (GND_1), IC901.12 (GND_2), IC901.13 (GND_3), IC901.24 (GND_4), IC902.10 (GND), Q901.1 (R2); also elsewhere on the board
unnamed: C902.1, IC901.9 (VCC_RF), Q901.4 (S2), R904.2, R906.2
unnamed: IC902.1 (DIR1), IC902.7 (DIR3), IC902.8 (DIR4), R902.1
unnamed: L901.2, R905.2
unnamed: Q901.2 (D2_1), Q901.3 (D2_2), R904.1, R905.1
unnamed: Q901.6 (R1,_C1), R906.1
VDD: IC902.16 (VCCA), IC903.2 (S), R901.2, R902.2, R903.2; also elsewhere on the board

Notes on the sheet:
Q901, L901, R905, and C902 is only needed with active antenna (Taoglass FXP.611 is passive).R904 can be used instead of Q901, C902 and R906 for antenna always on.
Logic level converter with controlled output enable used to ensure tri-state on MOSI pins when GPS is turned off (and avoid waking up GPS on activity on MOSI line as describe by Rundhovde)

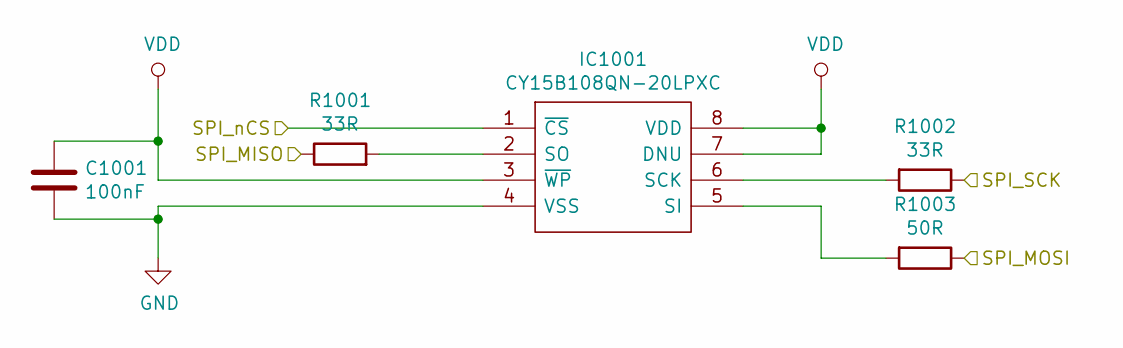
[picture p10: schematic cSLIM_FRAM.sch, cSLIM FRAM]

Parts:
C1001: 100nF; C_0603_1608Metric
IC1001: CY15B108QN-20LPXC; SON65P323X328X55-8N; Mouser Part Number 727-CY15B108QN20LPXC
R1001, R1002: 33R; R_0805_2012Metric
R1003: 50R; R_0805_2012Metric

Connections:
/P0.17: R1001.1; also elsewhere on the board
/P0.18: R1003.1; also elsewhere on the board
/P0.19: R1002.1; also elsewhere on the board
/P0.25: IC1001.1 (~CS); also elsewhere on the board
GND: C1001.2, IC1001.4 (VSS); also elsewhere on the board
unnamed: IC1001.2 (SO), R1001.2
unnamed: IC1001.5 (SI), R1003.2
unnamed: IC1001.6 (SCK), R1002.2
VDD: C1001.1, IC1001.3 (~WP), IC1001.7 (DNU), IC1001.8 (VDD); also elsewhere on the board

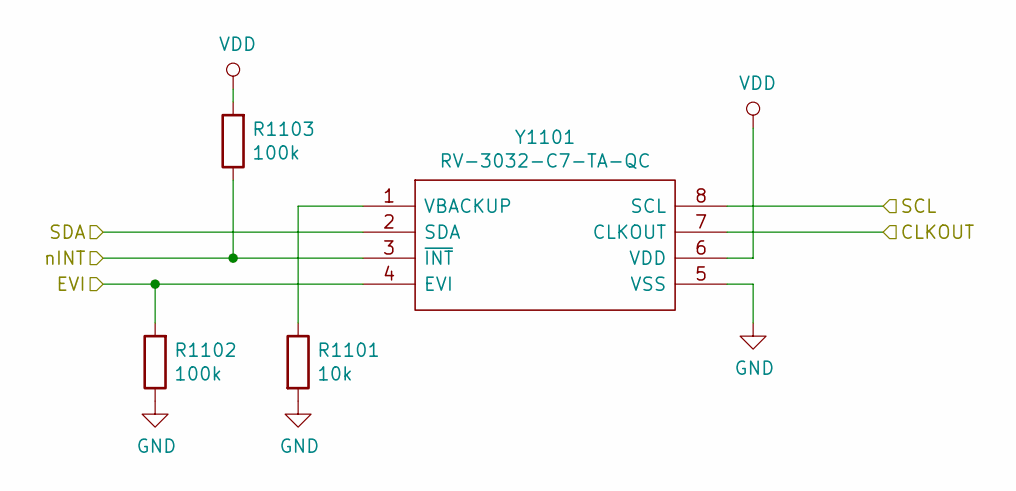
[picture p11: schematic cSLIM_RTC.sch, cSLIM RTC]

Parts:
R1101: 10k; R_0805_2012Metric
R1102, R1103: 100k; R_0805_2012Metric
Y1101: RV-3032-C7-TA-QC; RV3032C7TAQA; Manufacturer_Part_Number RV-3032-C7-TA-QC

Connections:
/GPS_TIMEPULSE: R1102.2, Y1101.4 (EVI); also elsewhere on the board
/I2C_SCL: Y1101.8 (SCL); also elsewhere on the board
/I2C_SDA: Y1101.2 (SDA); also elsewhere on the board
/P0.03: R1103.1, Y1101.3 (~INT); also elsewhere on the board
/P0.26: Y1101.7 (CLKOUT); also elsewhere on the board
GND: R1101.2, R1102.1, Y1101.5 (VSS); also elsewhere on the board
unnamed: R1101.1, Y1101.1 (VBACKUP)
VDD: R1103.2, Y1101.6 (VDD); also elsewhere on the board

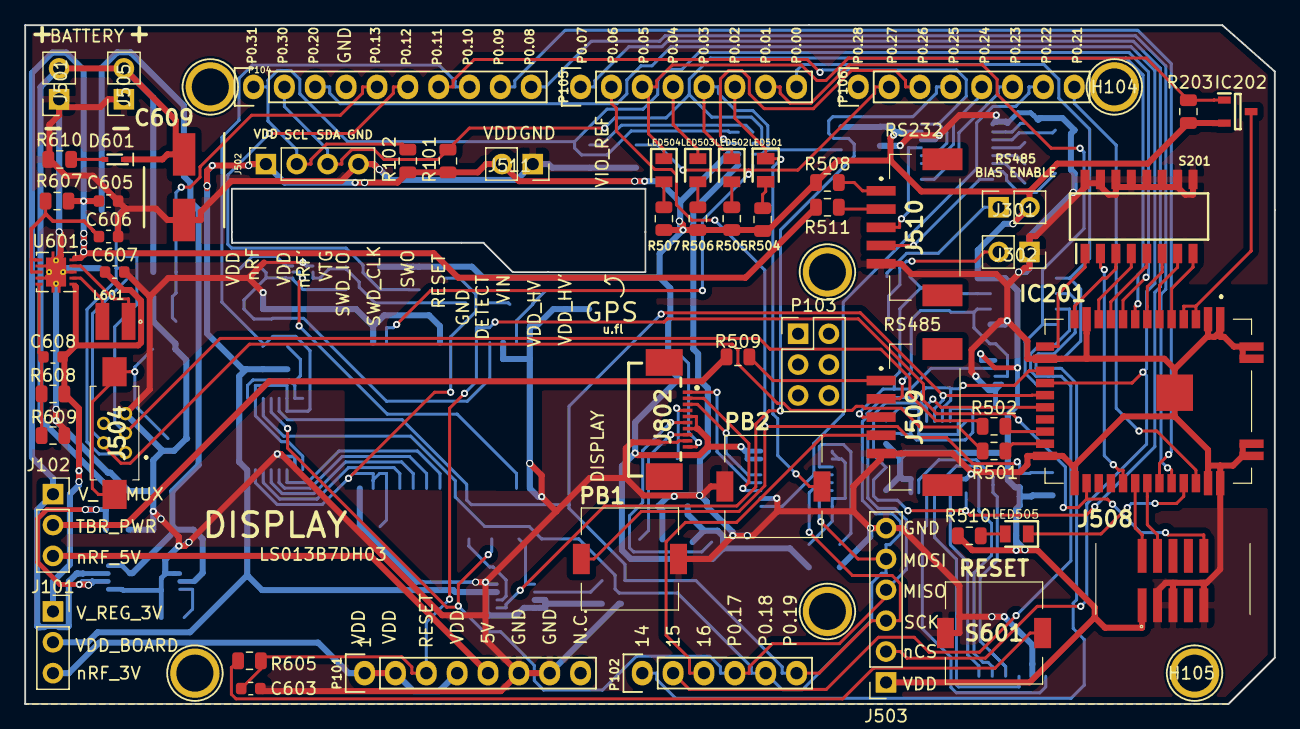
[picture p12: board cSLIM-shield.kicad_pcb from above]

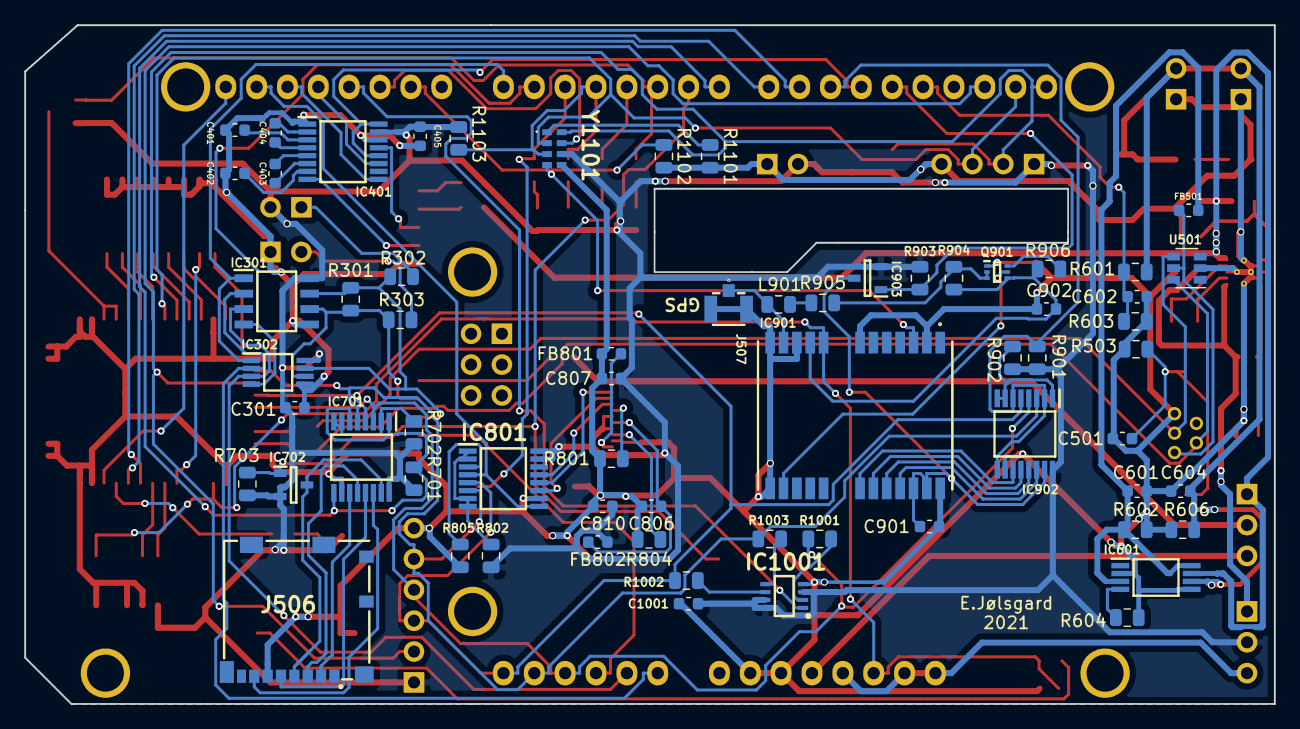
[picture p13: board cSLIM-shield.kicad_pcb from below]

Board: 2 copper layers, 102.9 x 55.9 mm, 128 parts (64 on the bottom side), 116 nets.
